soggybag/Dual-Delay/docs/DualDelay_schematic.pdf

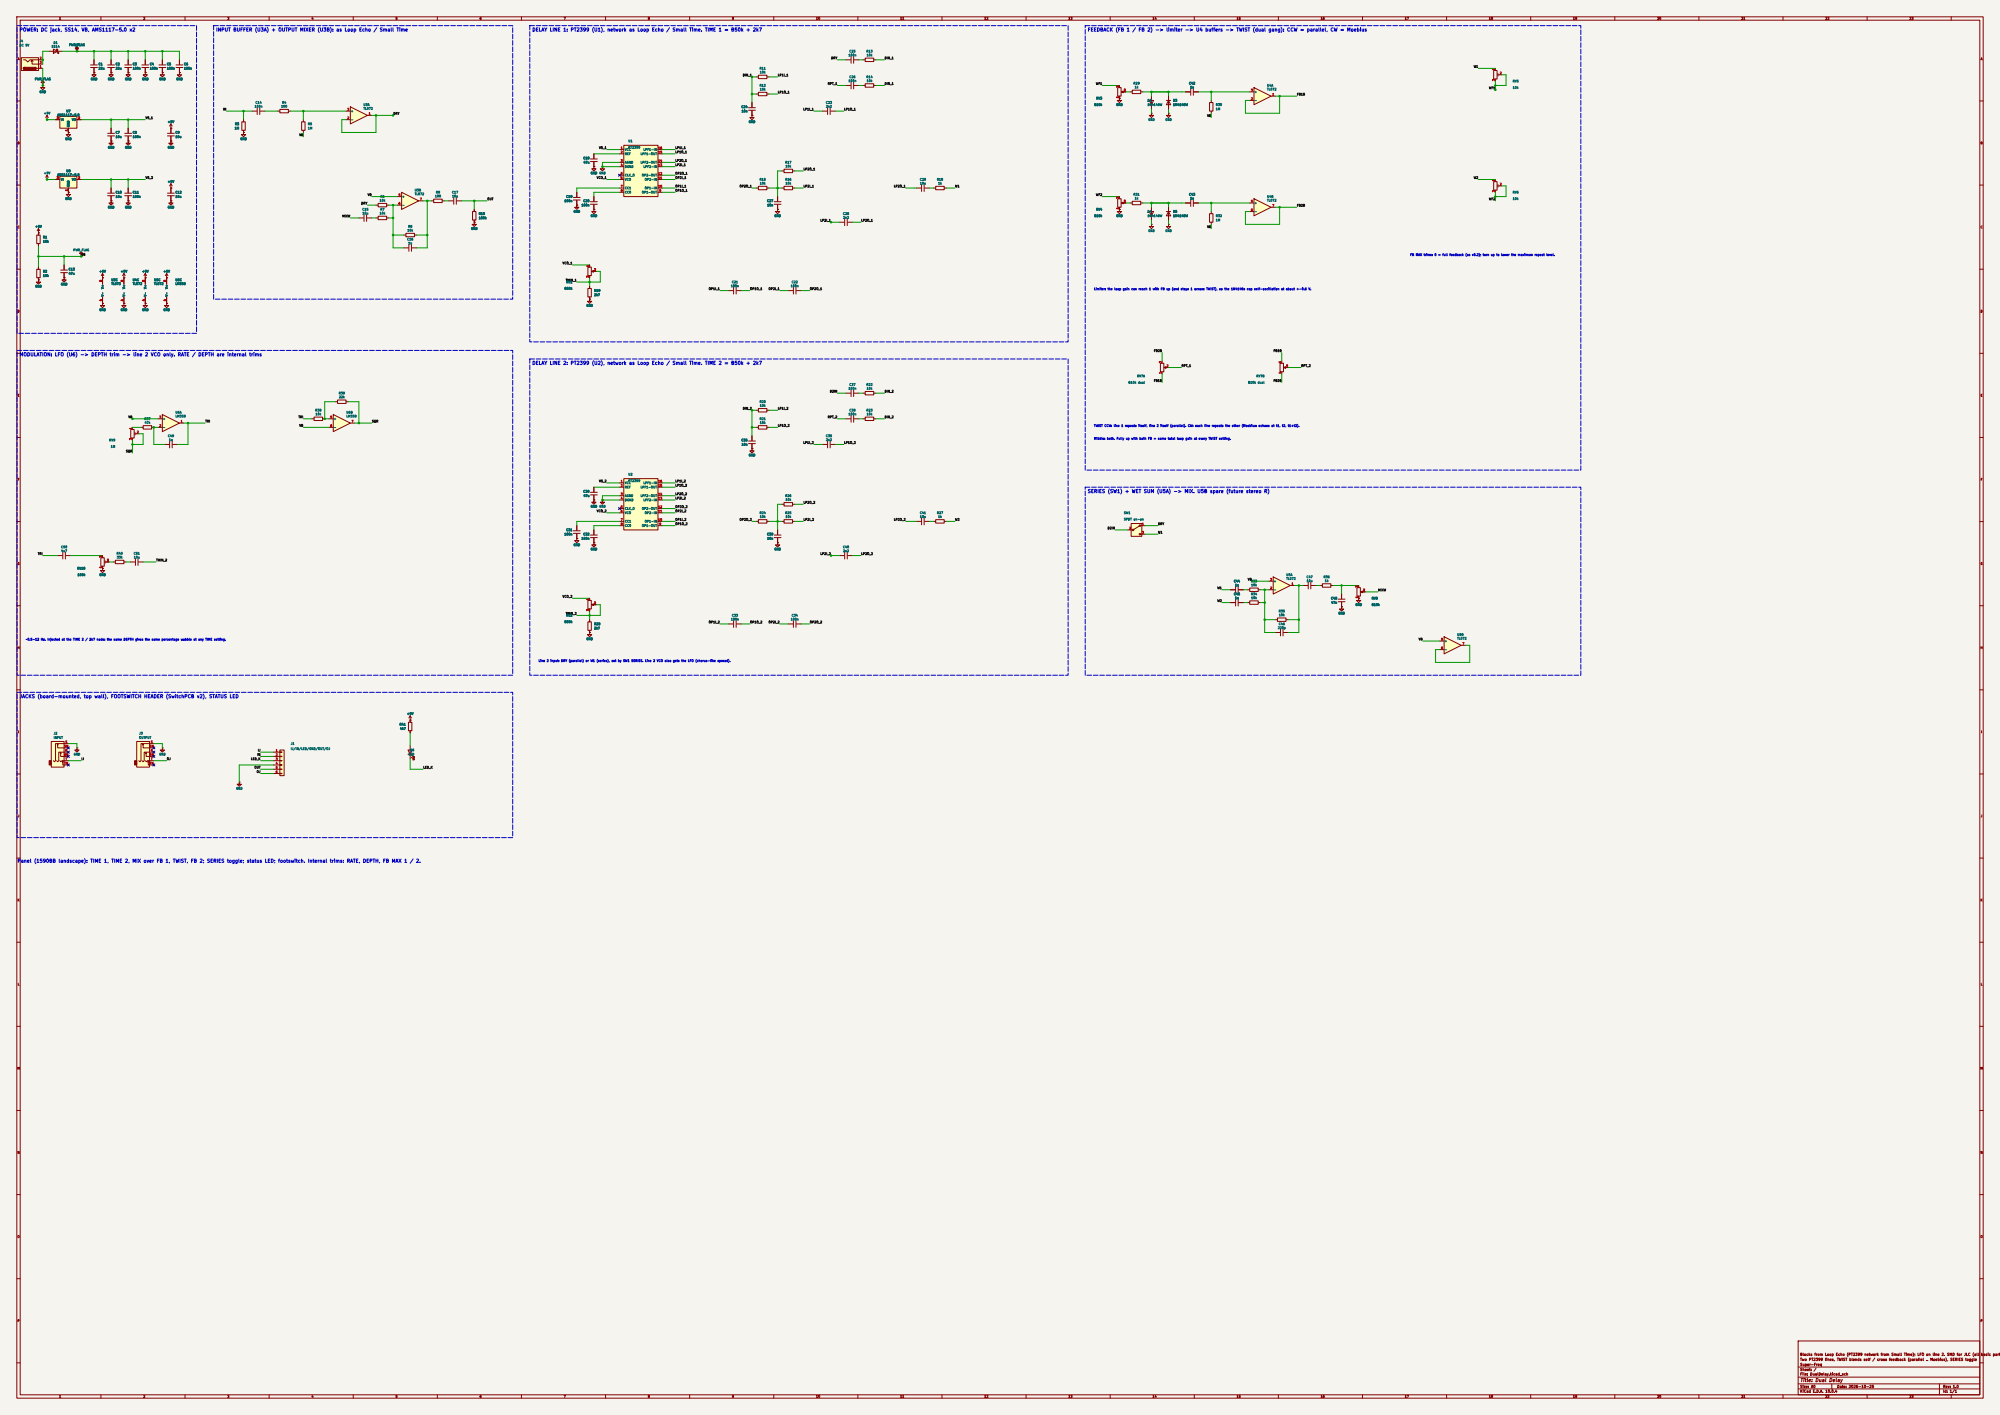
[picture p1: page 1]

POWER: DC jack, SS14, VB, AMS1117-5.0 x2

INPUT BUFFER (U3A) + OUTPUT MIXER (U3B): as Loop Echo / Small Time
10u GND +9V C4

DELAY LINE 1: PT2399 (U1), network as Loop Echo / Small Time. TIME 1 = B50k + 2k7

FEEDBACK (FB 1 / FB 2) -> limiter -> U4 buffers -> TWIST (dual gang): CCW = parallel, CW = Moebius

FB MAX trims: 0 = full feedback (as v0.2); turn up to lower the maximum repeat level.

Limiter: the loop gain can reach 1 with FB up (and stays 1 across TWIST), so the 1N4148s cap self-oscillation at about +-0.6 V. TWIST CCW: line 1 repeats itself, line 2 itself (parallel). CW: each line repeats the other (Moebius: echoes at t1, t2, t1+t2). Middle: both. Fully up with both FB = same total loop gain at every TWIST setting.

MODULATION: LFO (U6) -> DEPTH trim -> line 2 VCO only. RATE / DEPTH are internal trims

DELAY LINE 2: PT2399 (U2), network as Loop Echo / Small Time. TIME 2 = B50k + 2k7

SERIES (SW1) + WET SUM (U5A) -> MIX. U5B spare (future stereo R)

~0.5-12 Hz. Injected at the TIME 2 / 2k7 node: the same DEPTH gives the same percentage wobble at any TIME setting.

Line 2 input: DRY (parallel) or W1 (series), set by SW1 SERIES. Line 2 VCO also gets the LFO (chorus-like spread).

JACKS (board-mounted, top wall), FOOTSWITCH HEADER (SwitchPCB v2), STATUS LED

IJ/IN/LED/GND/OUT/OJ GND

Panel (1590BB landscape): TIME 1, TIME 2, MIX over FB 1, TWIST, FB 2; SERIES toggle; status LED; footswitch. Internal trims: RATE, DEPTH, FB MAX 1 / 2.

Two PT2399 lines, TWIST blends self / cross feedback (parallel .. Moebius), SERIES toggle
Super-Freq
Sheet: /
File: DualDelay.kicad_sch
Title: Dual Delay

Size: A0 | Rev: 1.0
KiCad E.D.A. 10.0.4 | Id: 1/1
