soggybag/Dual-Delay/DualDelay.kicad_pcb

## KiCad design DualDelay.kicad_pcb (2026-10-27)

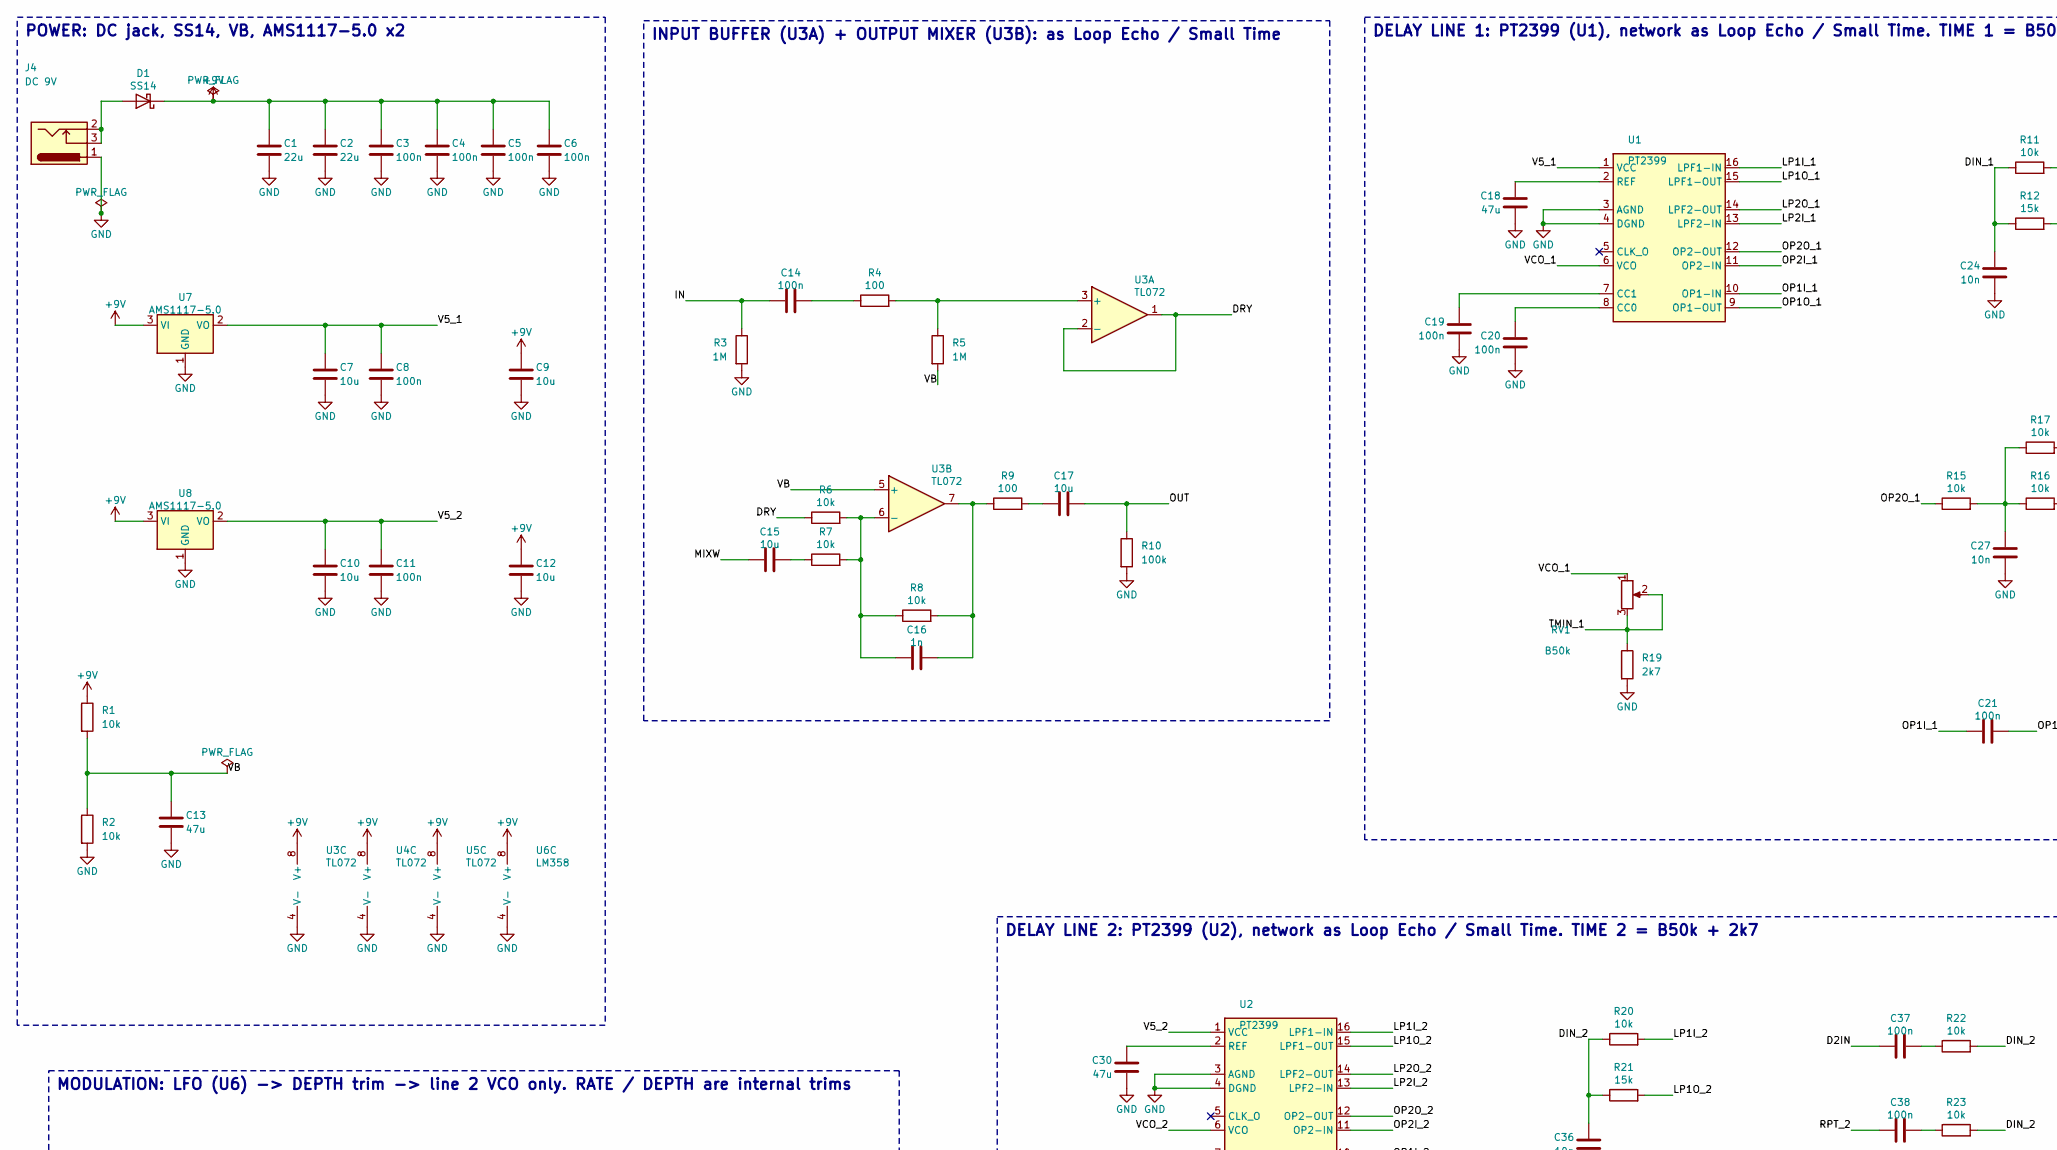
[picture p2: schematic DualDelay.kicad_sch, Dual Delay, part in row 1, column 1]

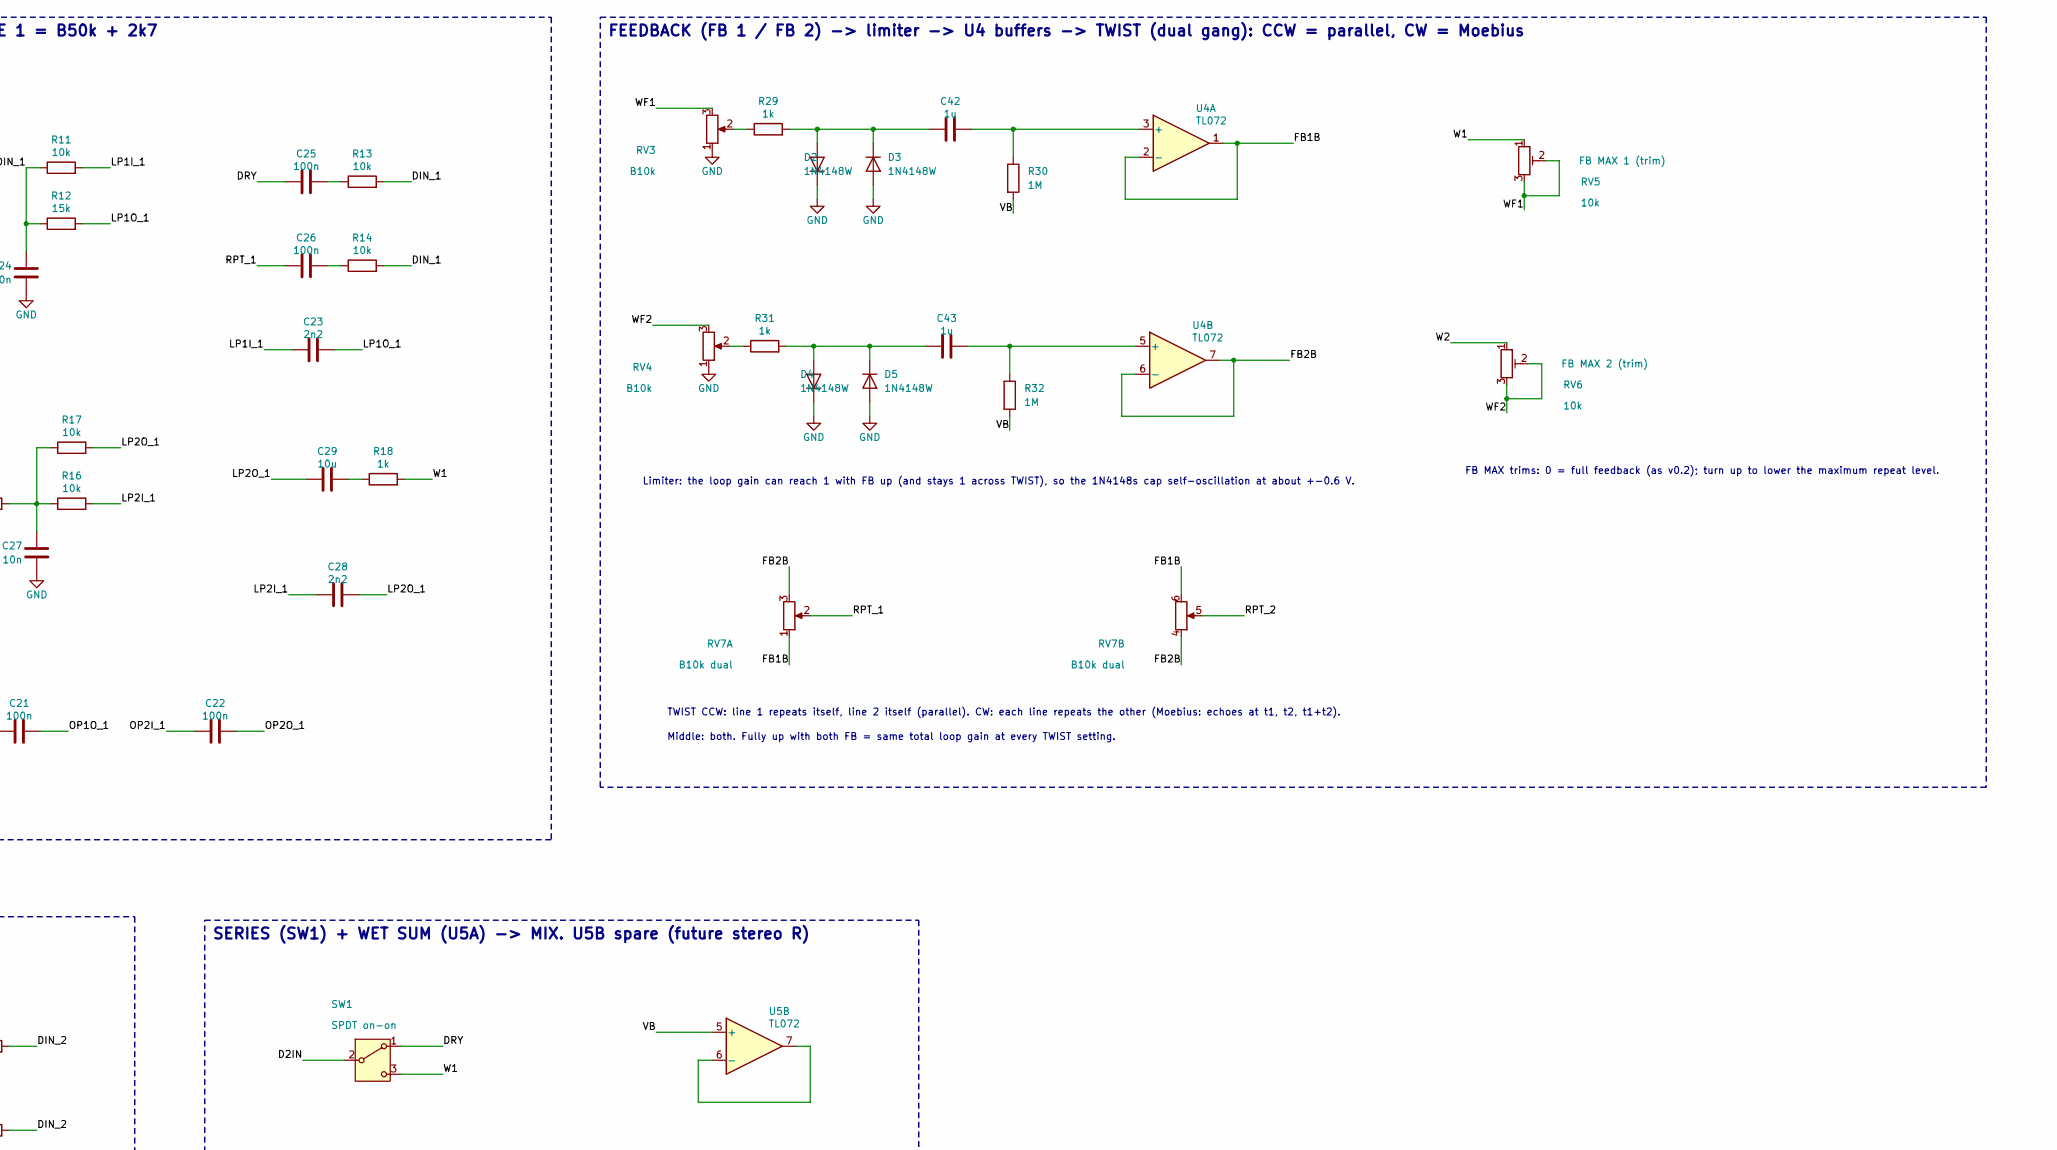
[picture p3: schematic DualDelay.kicad_sch, Dual Delay, part in row 1, column 2]

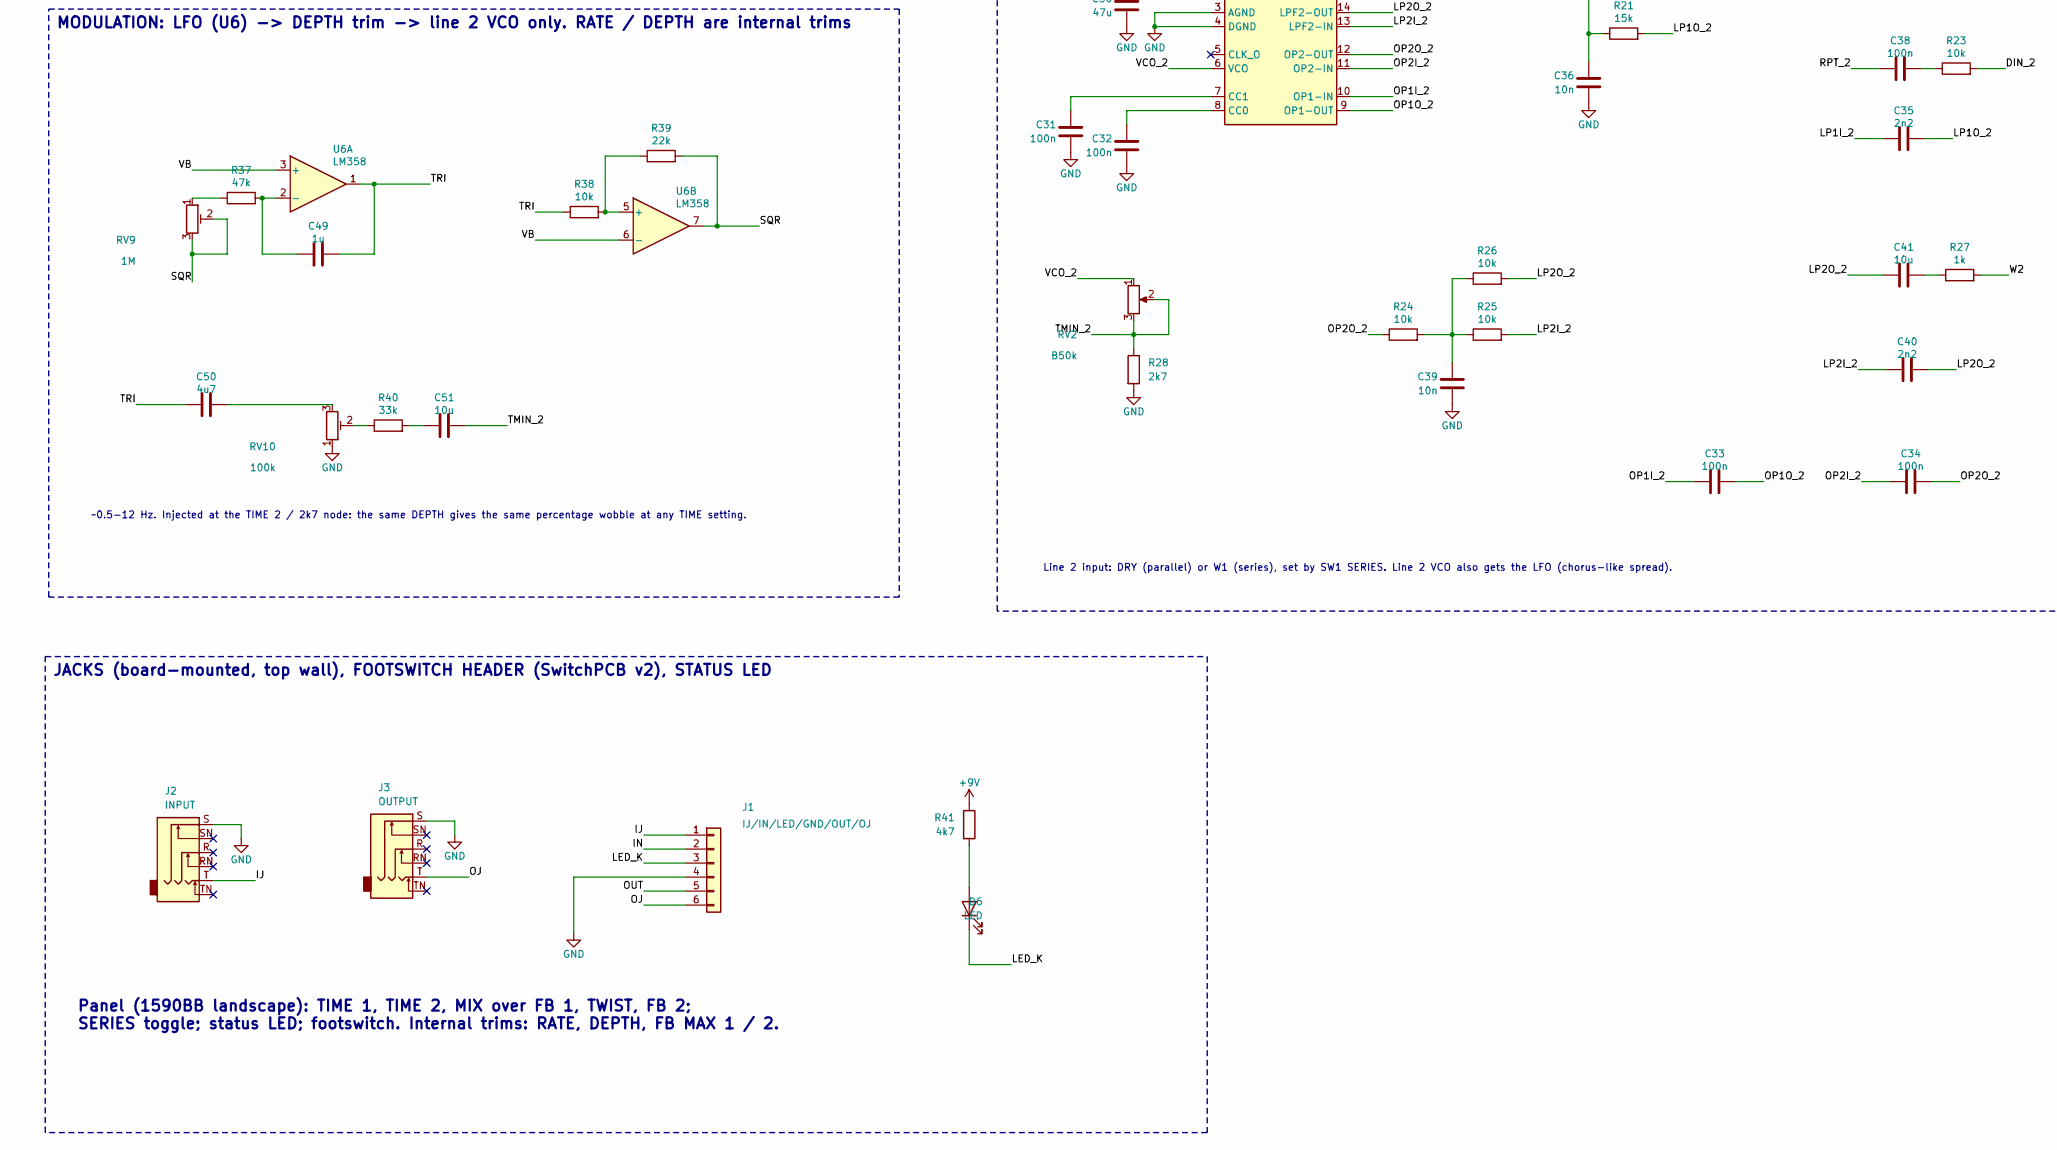
[picture p4: schematic DualDelay.kicad_sch, Dual Delay, part in row 2, column 1]

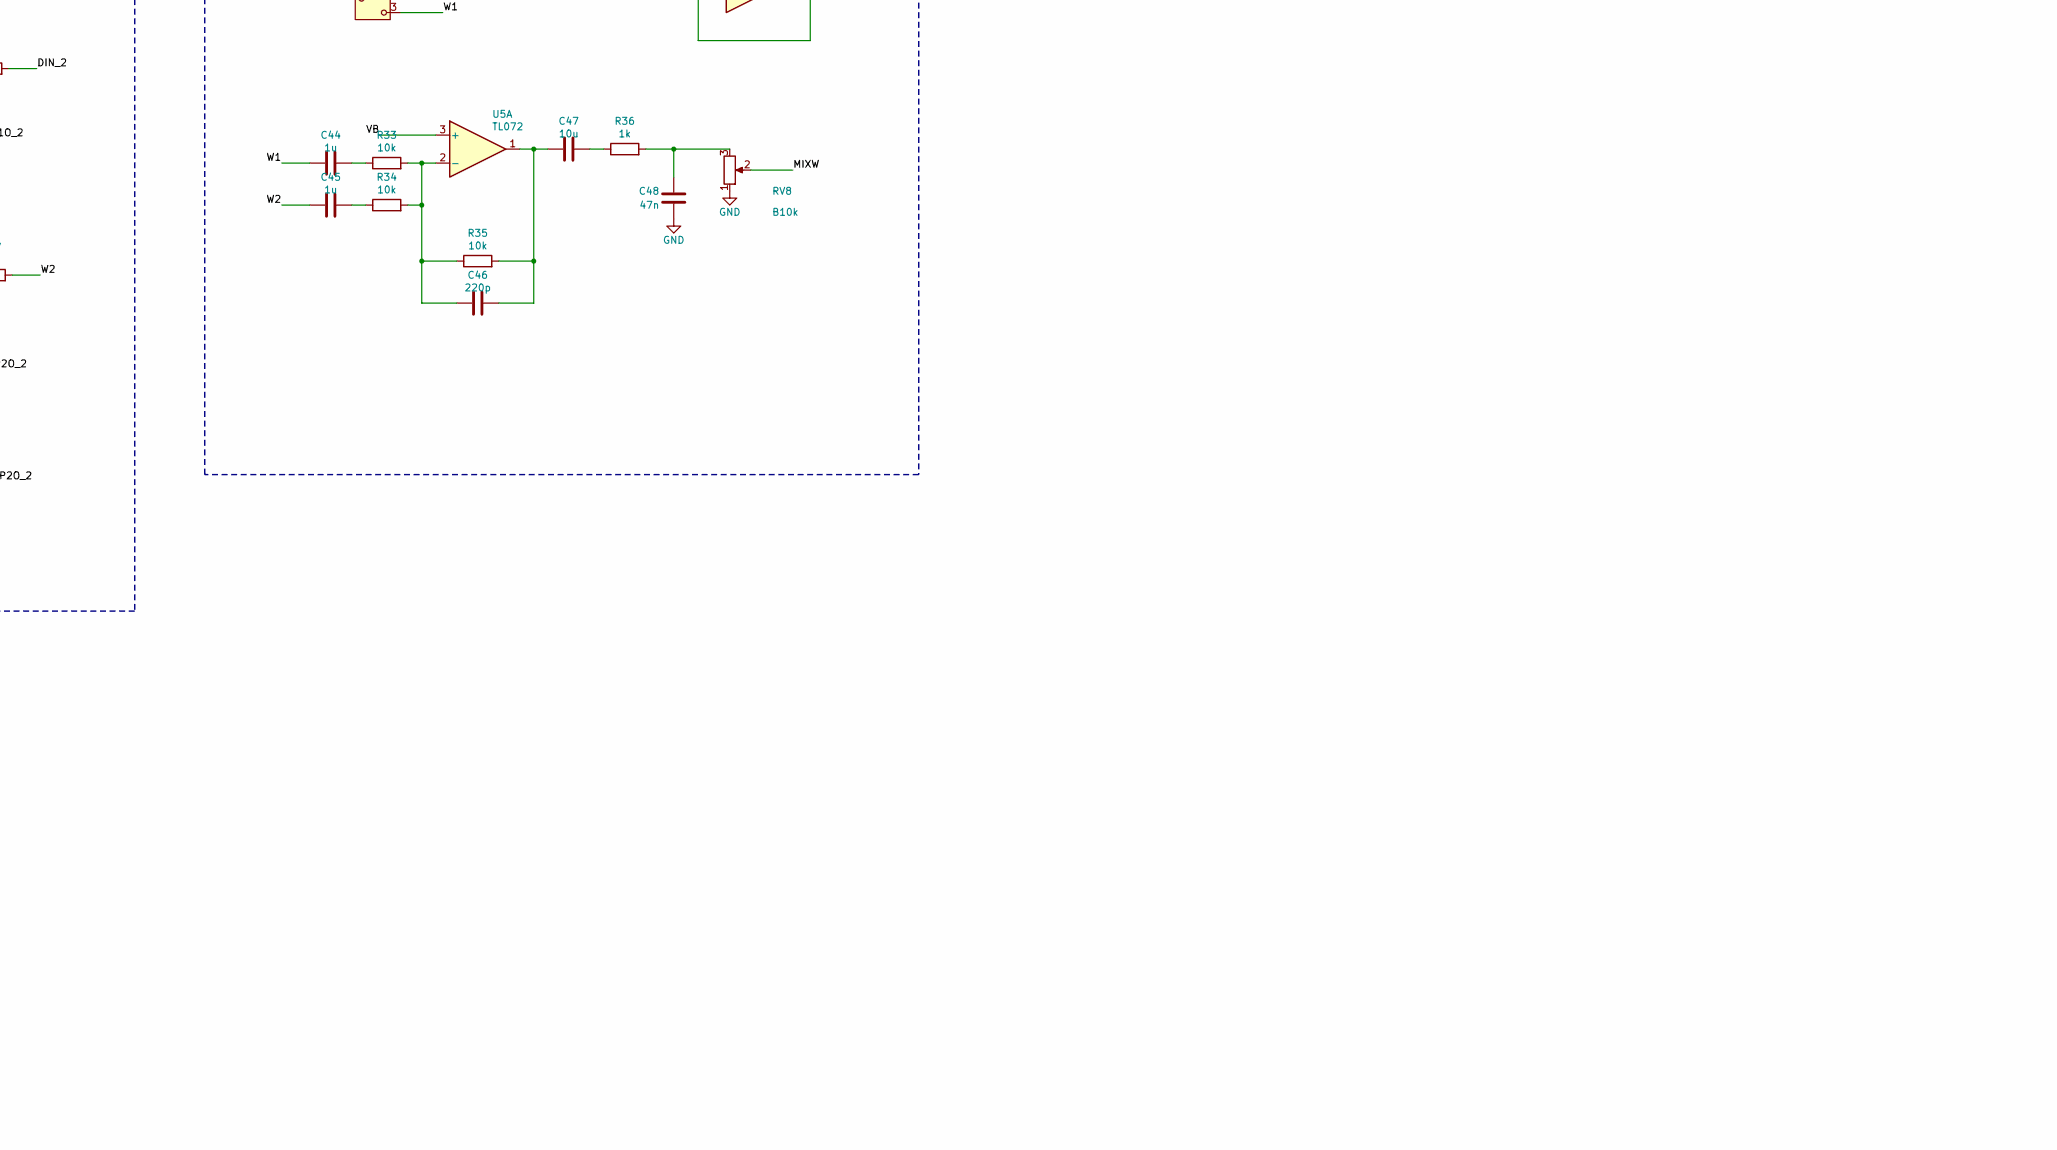
[picture p5: schematic DualDelay.kicad_sch, Dual Delay, part in row 2, column 2]

Parts:
C1, C2: 22u; C_0805_2012Metric_Pad1.18x1.45mm_HandSolder; LCSC C45783
C3, C4, C5, C6, C8, C11, C14, C19, C20, C21, C22, C25, C26, C31, C32, C33, C34, C37, C38: 100n; C_0805_2012Metric_Pad1.18x1.45mm_HandSolder; LCSC C49678
C7, C9, C10, C12, C15, C17, C29, C41, C47, C51: 10u; C_0805_2012Metric_Pad1.18x1.45mm_HandSolder; LCSC C15850
C13, C18, C30: 47u; C_1206_3216Metric_Pad1.33x1.80mm_HandSolder; LCSC C96123
C16: 1n; C_0805_2012Metric_Pad1.18x1.45mm_HandSolder; LCSC C46653
C23, C28, C35, C40: 2n2; C_0805_2012Metric_Pad1.18x1.45mm_HandSolder; LCSC C28260
C24, C27, C36, C39: 10n; C_0805_2012Metric_Pad1.18x1.45mm_HandSolder; LCSC C1710
C42, C43, C44, C45, C49: 1u; C_0805_2012Metric_Pad1.18x1.45mm_HandSolder; LCSC C28323
C46: 220p; C_0805_2012Metric_Pad1.18x1.45mm_HandSolder; LCSC C107145
C48: 47n; C_0805_2012Metric_Pad1.18x1.45mm_HandSolder; LCSC C53134
C50: 4u7; C_0805_2012Metric_Pad1.18x1.45mm_HandSolder; LCSC C1779
D1: SS14; D_SMA; LCSC C2480
D2, D3, D4, D5: 1N4148W; D_SOD-123; LCSC C81598
D6: LED; LED_D3.0mm
J1: IJ/IN/LED/GND/OUT/OJ; PinHeader_1x06_P2.54mm_Vertical
J2: INPUT; Jack_6.35mm_PJ-646F_Horizontal
J3: OUTPUT; Jack_6.35mm_PJ-646F_Horizontal
J4: DC 9V; DC_Jack_2.1mm_A-4118_Horizontal
R1, R2, R6, R7, R8, R11, R13, R14, R15, R16, R17, R20, R22, R23, R24, R25, R26, R33, R34, R35, R38: 10k; R_0805_2012Metric_Pad1.20x1.40mm_HandSolder; LCSC C17414
R3, R5, R30, R32: 1M; R_0805_2012Metric_Pad1.20x1.40mm_HandSolder; LCSC C17514
R4, R9: 100; R_0805_2012Metric_Pad1.20x1.40mm_HandSolder; LCSC C17408
R10: 100k; R_0805_2012Metric_Pad1.20x1.40mm_HandSolder; LCSC C149504
R12, R21: 15k; R_0805_2012Metric_Pad1.20x1.40mm_HandSolder; LCSC C17475
R18, R27, R29, R31, R36: 1k; R_0805_2012Metric_Pad1.20x1.40mm_HandSolder; LCSC C17513
R19, R28: 2k7; R_0805_2012Metric_Pad1.20x1.40mm_HandSolder; LCSC C17530
R37: 47k; R_0805_2012Metric_Pad1.20x1.40mm_HandSolder; LCSC C17713
R39: 22k; R_0805_2012Metric_Pad1.20x1.40mm_HandSolder; LCSC C17560
R40: 33k; R_0805_2012Metric_Pad1.20x1.40mm_HandSolder; LCSC C17633
R41: 4k7; R_0805_2012Metric_Pad1.20x1.40mm_HandSolder; LCSC C17673
RV1, RV2: B50k; Potentiometer_Alpha_RD901F-40-00D_Single_Vertical
RV3, RV4, RV8: B10k; Potentiometer_Alpha_RD901F-40-00D_Single_Vertical
RV5, RV6: 10k; Potentiometer_Bourns_3296W_Vertical
RV7: B10k dual; Potentiometer_9mm_Dual_Vertical_Tayda
RV9: 1M; Potentiometer_Bourns_3296W_Vertical
RV10: 100k; Potentiometer_Bourns_3296W_Vertical
SW1: SPDT on-on; SW_Taiway_100_SPDT_PC
U1, U2: PT2399; SOIC-16_3.9x9.9mm_P1.27mm; LCSC C126407
U3, U4, U5: TL072; SOIC-8_3.9x4.9mm_P1.27mm; LCSC C6961
U6: LM358; SOIC-8_3.9x4.9mm_P1.27mm; LCSC C7950
U7, U8: AMS1117-5.0; SOT-223-3_TabPin2; LCSC C6187

Connections:
/D2IN: C37.1, SW1.2 (B)
/DIN_1: C24.1, R11.1, R12.1, R13.2, R14.2
/DIN_2: C36.1, R20.1, R21.1, R22.2, R23.2
/DRY: C25.1, R6.1, SW1.1 (A), U3.1, U3.2 (-)
/FB1B: RV7.1, RV7.6, U4.1, U4.2 (-)
/FB2B: RV7.3, RV7.4, U4.6 (-), U4.7
/IJ: J1.1, J2.T
/IN: C14.1, J1.2, R3.1
/LED_K: D6.1 (K), J1.3
/LP1I_1: C23.1, R11.2, U1.16 (LPF1-IN)
/LP1I_2: C35.1, R20.2, U2.16 (LPF1-IN)
/LP1O_1: C23.2, R12.2, U1.15 (LPF1-OUT)
/LP1O_2: C35.2, R21.2, U2.15 (LPF1-OUT)
/LP2I_1: C28.1, R16.2, U1.13 (LPF2-IN)
/LP2I_2: C40.1, R25.2, U2.13 (LPF2-IN)
/LP2O_1: C28.2, C29.1, R17.2, U1.14 (LPF2-OUT)
/LP2O_2: C40.2, C41.1, R26.2, U2.14 (LPF2-OUT)
/MIXW: C15.1, RV8.2
/OJ: J1.6, J3.T
/OP1I_1: C21.1, U1.10 (OP1-IN)
/OP1I_2: C33.1, U2.10 (OP1-IN)
/OP1O_1: C21.2, U1.9 (OP1-OUT)
/OP1O_2: C33.2, U2.9 (OP1-OUT)
/OP2I_1: C22.1, U1.11 (OP2-IN)
/OP2I_2: C34.1, U2.11 (OP2-IN)
/OP2O_1: C22.2, R15.1, U1.12 (OP2-OUT)
/OP2O_2: C34.2, R24.1, U2.12 (OP2-OUT)
/OUT: C17.2, J1.5, R10.1
/RPT_1: C26.1, RV7.2
/RPT_2: C38.1, RV7.5
/SQR: R39.2, RV9.2, RV9.3, U6.7
/TMIN_1: R19.1, RV1.2, RV1.3
/TMIN_2: C51.1, R28.1, RV2.2, RV2.3
/TRI: C49.2, C50.1, R38.1, U6.1
/V5_1: C7.1, C8.1, U1.1 (VCC), U7.2 (VO)
/V5_2: C10.1, C11.1, U2.1 (VCC), U8.2 (VO)
/VCO_1: RV1.1, U1.6 (VCO)
/VCO_2: RV2.1, U2.6 (VCO)
/W1: C44.1, R18.2, RV5.1, SW1.3 (C)
/W2: C45.1, R27.2, RV6.1
/WF1: RV3.3, RV5.2, RV5.3
/WF2: RV4.3, RV6.2, RV6.3
unnamed: C14.2, R4.1
unnamed: C15.2, R7.1
unnamed: C16.2, R8.2, R9.1, U3.7
unnamed: C17.1, R9.2
unnamed: C25.2, R13.1
unnamed: C26.2, R14.1
unnamed: C27.1, R15.2, R16.1, R17.1
unnamed: C29.2, R18.1
unnamed: C37.2, R22.1
unnamed: C38.2, R23.1
unnamed: C39.1, R24.2, R25.1, R26.1
unnamed: C41.2, R27.1
unnamed: C44.2, R33.1
unnamed: C45.2, R34.1
unnamed: C46.2, C47.1, R35.2, U5.1
unnamed: C47.2, R36.1
unnamed: C48.1, R36.2, RV8.3
unnamed: C50.2, RV10.3
unnamed: C51.2, R40.2
unnamed: D1.2 (A), J4.2, J4.3
unnamed: C42.1, D2.2 (A), D3.1 (K), R29.2
unnamed: C43.1, D4.2 (A), D5.1 (K), R31.2
unnamed: D6.2 (A), R41.2
unnamed: R29.1, RV3.2
unnamed: R31.1, RV4.2
unnamed: R37.1, RV9.1
unnamed: R40.1, RV10.2
unnamed: C20.1, U1.8 (CC0)
unnamed: C19.1, U1.7 (CC1)
unnamed: C18.1, U1.2 (REF)
unnamed: C32.1, U2.8 (CC0)
unnamed: C31.1, U2.7 (CC1)
unnamed: C30.1, U2.2 (REF)
unnamed: R4.2, R5.1, U3.3 (+)
unnamed: C16.1, R6.2, R7.2, R8.1, U3.6 (-)
unnamed: C42.2, R30.1, U4.3 (+)
unnamed: C43.2, R32.1, U4.5 (+)
unnamed: C46.1, R33.2, R34.2, R35.1, U5.2 (-)
unnamed: U5.6 (-), U5.7
unnamed: C49.1, R37.2, U6.2 (-)
unnamed: R38.2, R39.1, U6.5 (+)

Notes on the sheet:
DELAY LINE 2: PT2399 (U2), network as Loop Echo / Small Time. TIME 2 = B50k + 2k7
MODULATION: LFO (U6) -> DEPTH trim -> line 2 VCO only. RATE / DEPTH are internal trims
~0.5-12 Hz. Injected at the TIME 2 / 2k7 node: the same DEPTH gives the same percentage wobble at any TIME setting.
Limiter: the loop gain can reach 1 with FB up (and stays 1 across TWIST), so the 1N4148s cap self-oscillation at about +-0.6 V.
TWIST CCW: line 1 repeats itself, line 2 itself (parallel). CW: each line repeats the other (Moebius: echoes at t1, t2, t1+t2).
SERIES (SW1) + WET SUM (U5A) -> MIX. U5B spare (future stereo R)
INPUT BUFFER (U3A) + OUTPUT MIXER (U3B): as Loop Echo / Small Time
POWER: DC jack, SS14, VB, AMS1117-5.0 x2
Line 2 input: DRY (parallel) or W1 (series), set by SW1 SERIES. Line 2 VCO also gets the LFO (chorus-like spread).
Panel (1590BB landscape): TIME 1, TIME 2, MIX over FB 1, TWIST, FB 2; SERIES toggle; status LED; footswitch. Internal trims: RATE, DEPTH, FB MAX 1 / 2.
Middle: both. Fully up with both FB = same total loop gain at every TWIST setting.
FB MAX trims: 0 = full feedback (as v0.2); turn up to lower the maximum repeat level.
FEEDBACK (FB 1 / FB 2) -> limiter -> U4 buffers -> TWIST (dual gang): CCW = parallel, CW = Moebius
JACKS (board-mounted, top wall), FOOTSWITCH HEADER (SwitchPCB v2), STATUS LED
DELAY LINE 1: PT2399 (U1), network as Loop Echo / Small Time. TIME 1 = B50k + 2k7

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
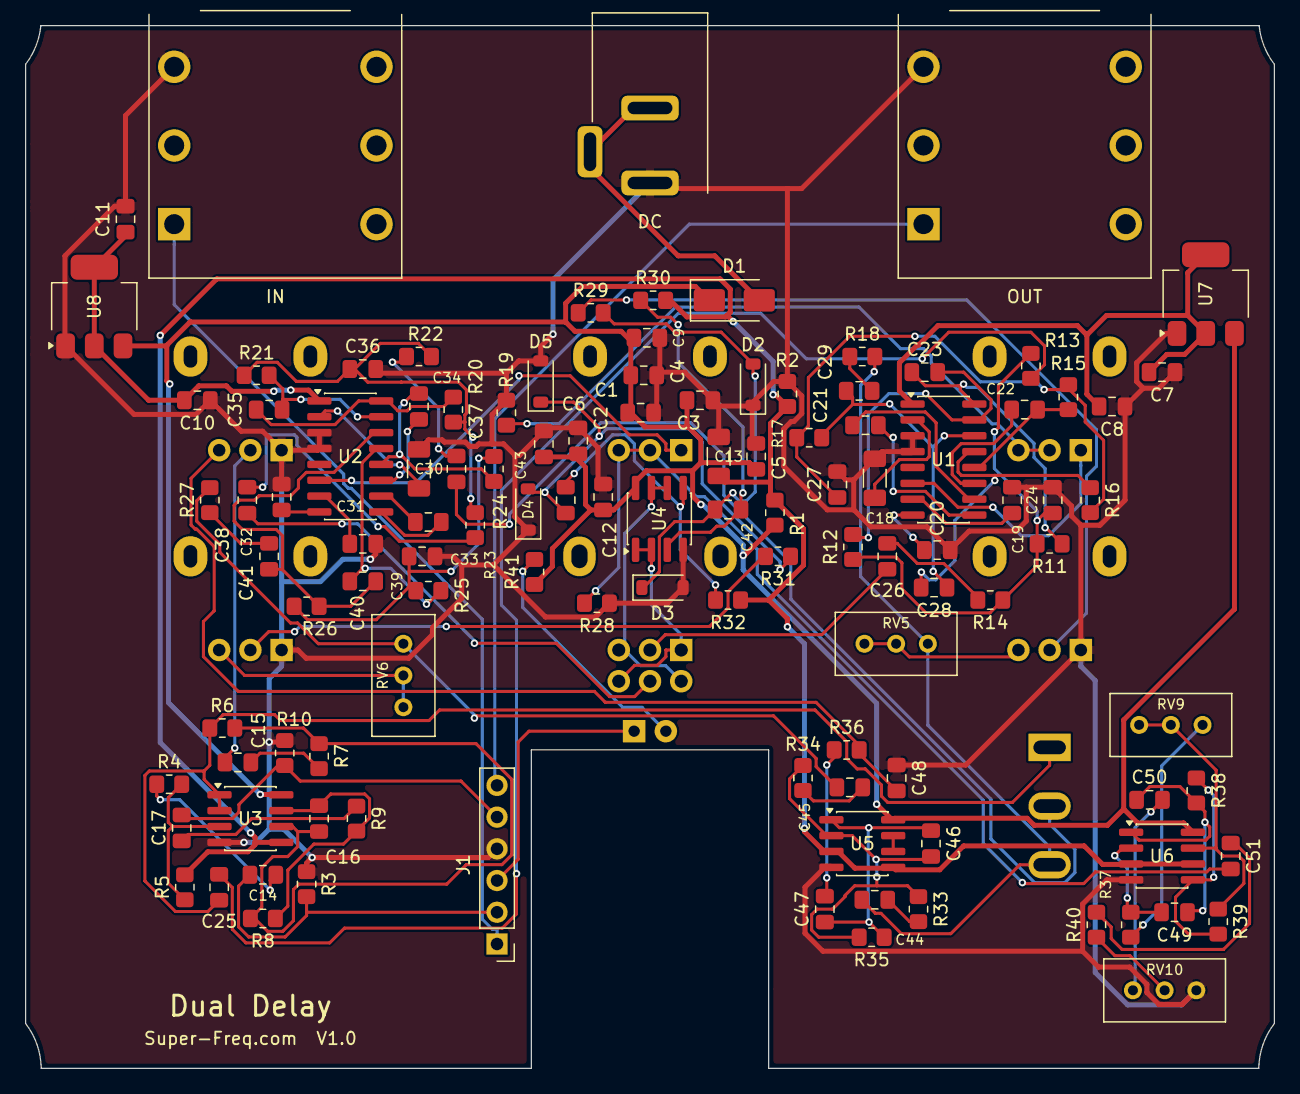
[picture p6: board DualDelay.kicad_pcb from above]

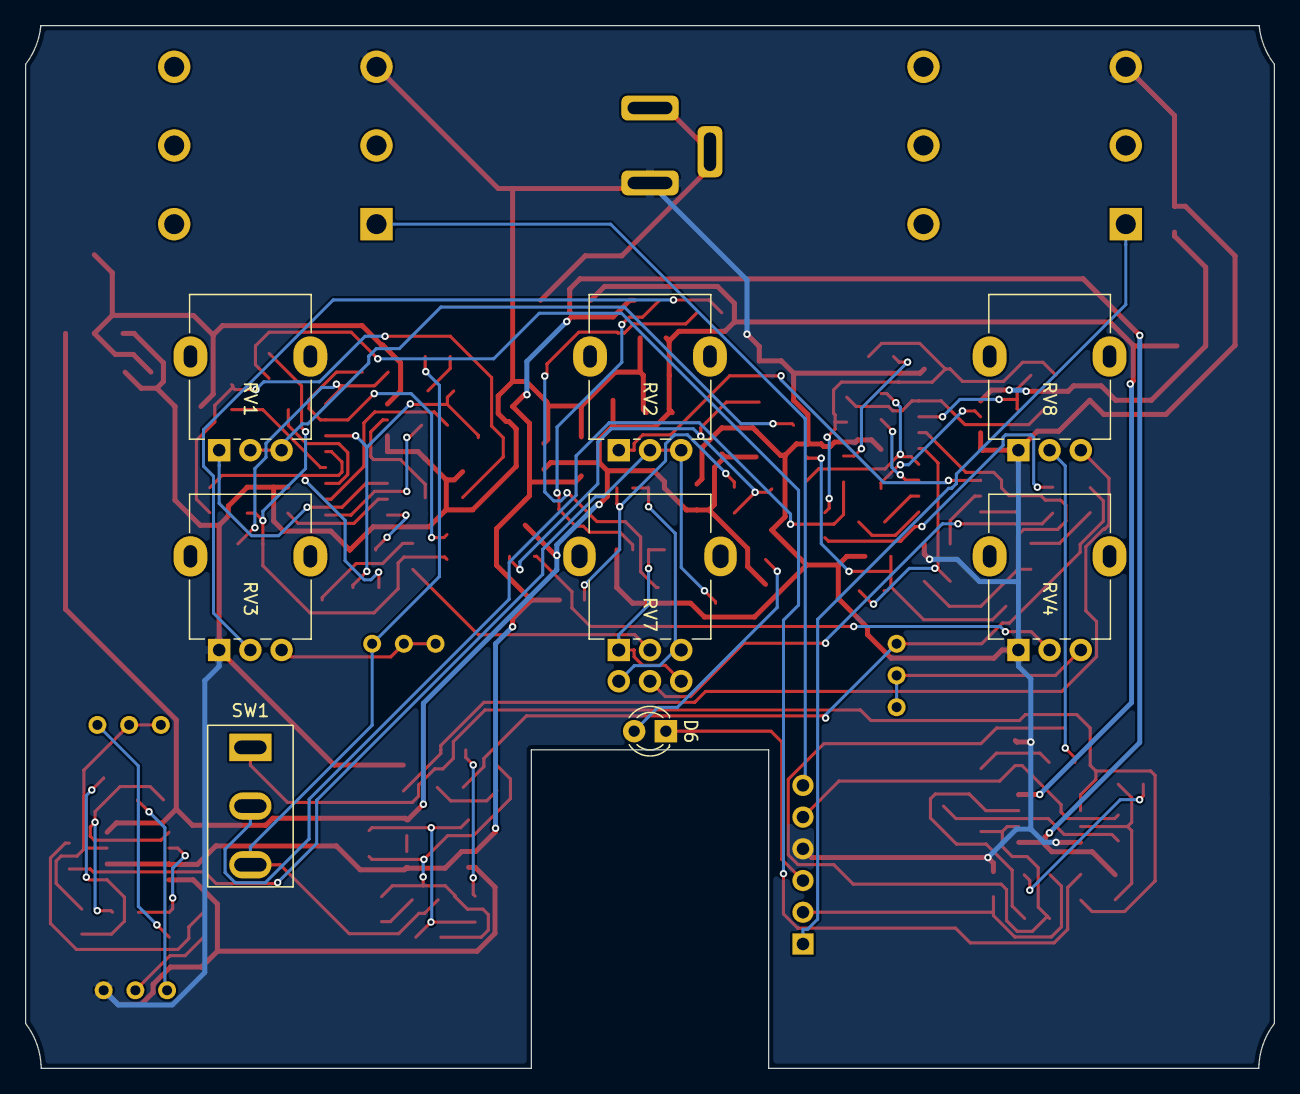
[picture p7: board DualDelay.kicad_pcb from below]

Board: 2 copper layers, 100.0 x 83.5 mm, 121 parts (8 on the bottom side), 86 nets.
