soggybag/Dual-Delay/(commit log)

2026-10-25 Dual Delay: idea notes and v0.1 breadboard schematic (two PT2399 lines, TWIST self/cross feedback, SERIES, LFO on line 2)
    [DualDelay.kicad_sch]
2026-10-25 Ideas: Dragonfish notes (LFO into the TIME/R_min node, darker voicing option, low-power LFO op-amp)
2026-10-25 v0.2 breadboard: LFO into the TIME 2 / 2k7 node (even depth), 2k7 minimum delay, LM358 LFO; breadboard plan
    [DualDelay.kicad_sch]
2026-10-26 v1.0 SMD board: 1590BB landscape, three jacks on top (OUT DC IN)
    - Schematic (A0, ERC 0): footprints + LCSC (all basic except the PT2399s), MLCC,
    one AMS1117-5.0 per PT2399, FB MAX 1 / 2 trims, 3296W RATE / DEPTH trims,
    PJ-646F / A-4118 jacks, status LED, 1x6 SwitchPCB header. v0.2 kept as
    build_dualdelay_v0.2.py.
    - Board (Loop Echo geometry, 100 x 83.5 mm): PT2399s and their regulators at
    opposite ends, slotted Taiway SERIES toggle, dual TWIST pot. DRC 0 errors /
    0 unconnected, parity clean, 73 vias.
    - Enclosure drilling files (make_enclosure.py); fab files in production/ (gitignored).
    [DualDelay.kicad_pcb, DualDelay.kicad_sch, DualDelay_1590BB_drill.csv]
2026-10-26 Re-route with the 0.4 mm Power net class restored
    Power class in DualDelay.kicad_pro (+9V, GND, V5_1, V5_2, VB, D1-A; Default 0.25 mm), board re-routed
    (99 vias, DRC 0/0, parity clean; C32 GND pad solid); buildpcb now restores the .kicad_pro at exit.
    [DualDelay.kicad_pcb, DualDelay.kicad_sch]
2026-10-27 Silk pass: references clear of pads and other silk
    Reference designators moved next to their parts (0.8-1.0 mm text), off pads, other silk and the board edge;
    copper unchanged, DRC 0 errors / 0 unconnected, parity clean. Fab files regenerated (production/, gitignored).
    [DualDelay.kicad_pcb]
